sjuaero/Modeling-Gyrocopter-/docs/images/rotor_pin.png

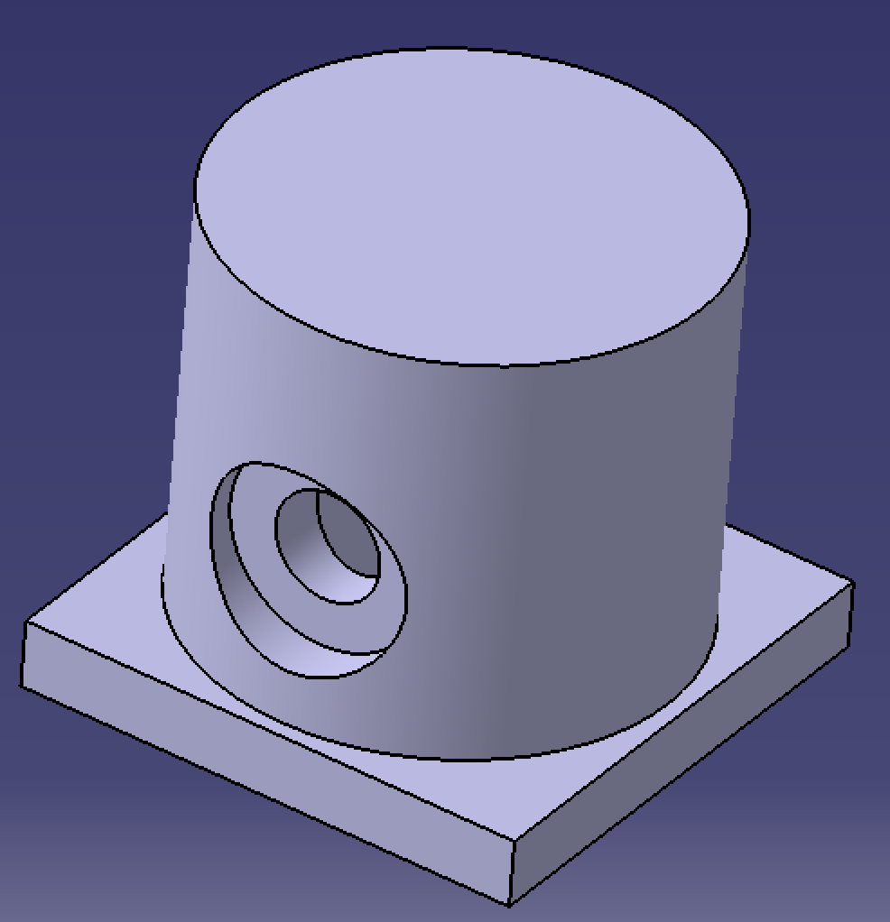
docs/images/rotor_pin.png
