sjuaero/Modeling-Gyrocopter-/docs/notes/material_selection.docx

1. 동력 프로펠러

10X7 정방향 피치

[팰콘샵] [APC] 10X7SF Slow Flyer (https://www.falconshop.co.kr/shop/goods/goods_view.php?goodsno=99995893)

->만약, 기체가 작다면 8X5

[팰콘샵] HD E-Propeller 8x5 (8050) (https://www.falconshop.co.kr/shop/goods/goods_view.php?goodsno=100003141)

2. 서보 모터

기체를 2KG 내로 선정 시,

[팰콘샵] [TOWER PRO] 타워프로 카피 SG90 9g 미니서보 / 서보혼 3가지타입 포함 (https://www.falconshop.co.kr/shop/goods/goods_view.php?goodsno=100076990&category=026005) => 최대 토크 1.8kg/cm

2kg 이상 시,

[팰콘샵] [SURPASS HOBBY] 6KG/0.16S S0600P Digital Servo (https://www.falconshop.co.kr/shop/goods/goods_view.php?goodsno=100082806)

3. 볼트 및 와셔, 너트

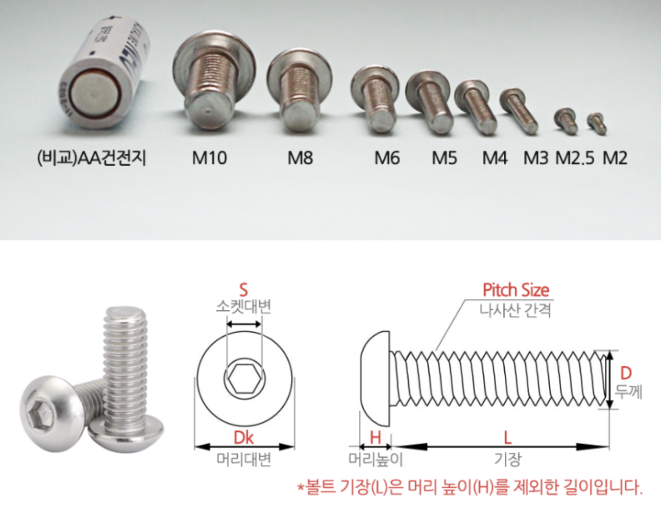
[picture p31: figure]
나사이(가) 표시된 사진 AI가 생성한 콘텐츠는 부정확할 수 있습니다.
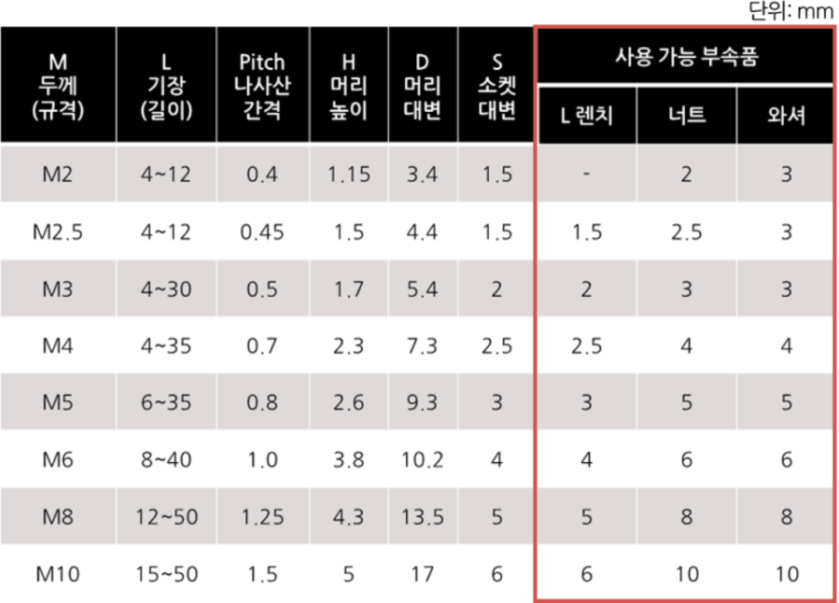
[picture p32: figure]
텍스트, 스크린샷, 번호, 폰트이(가) 표시된 사진 AI가 생성한 콘텐츠는 부정확할 수 있습니다.

필요 볼트 사이즈 : M2.5, M3 X 35, M3X 30

1. 로터 헤드

-높이 : 중앙 – 9.2cm

-높이 : 중앙 가장자리(2개) – 9.7cm

-높이 : 로터 – 로테헤드 부분(4개) – 7.64cm

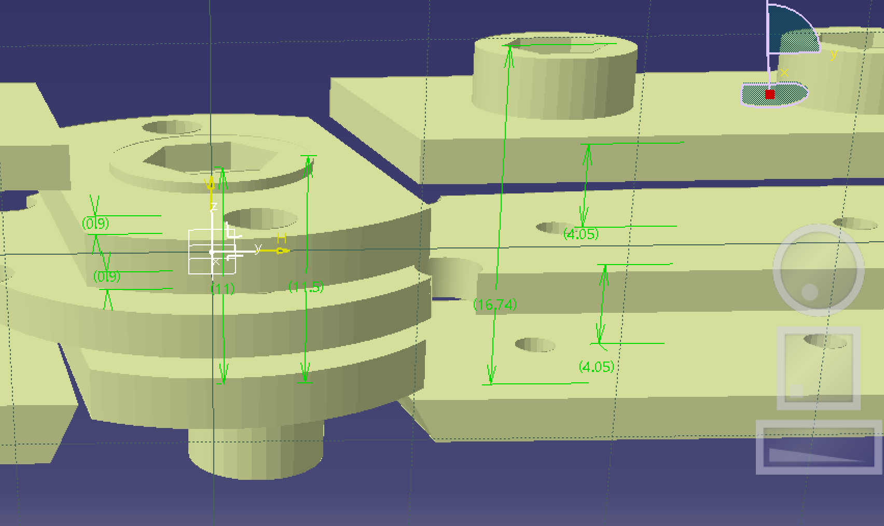
[picture p33: figure]
스크린샷, 축적 모형이(가) 표시된 사진 AI가 생성한 콘텐츠는 부정확할 수 있습니다.

-너비(로터 헤드 중앙)

소켓 대변 :

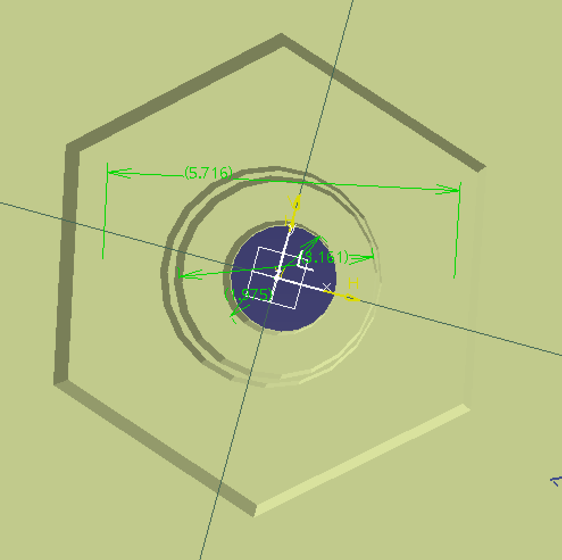
[picture p34: figure]
원, 도표, 라인, 스크린샷이(가) 표시된 사진 AI가 생성한 콘텐츠는 부정확할 수 있습니다.

- 중앙 가장자리(2개) : 파악 불가..

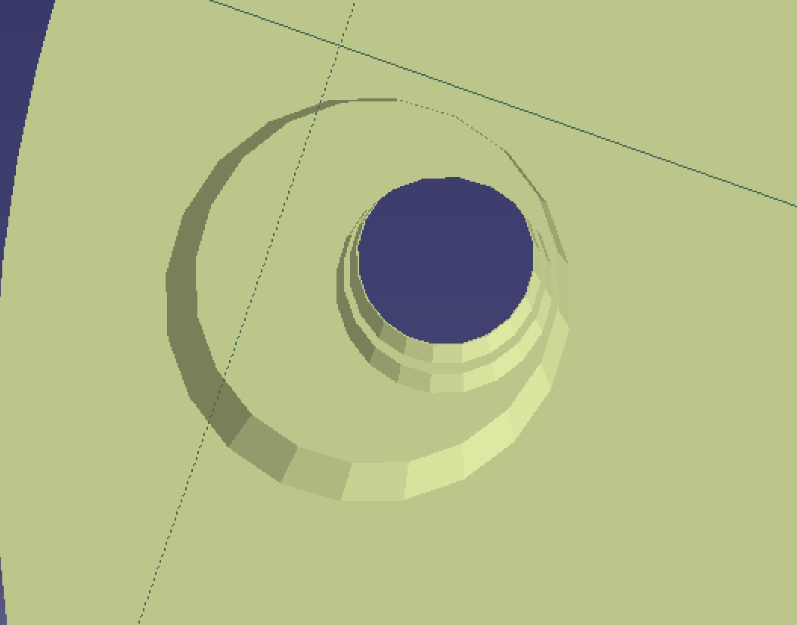
[picture p35: figure]
원, 스크린샷, 예술, 다채로움이(가) 표시된 사진 AI가 생성한 콘텐츠는 부정확할 수 있습니다.

와셔 : 불필요

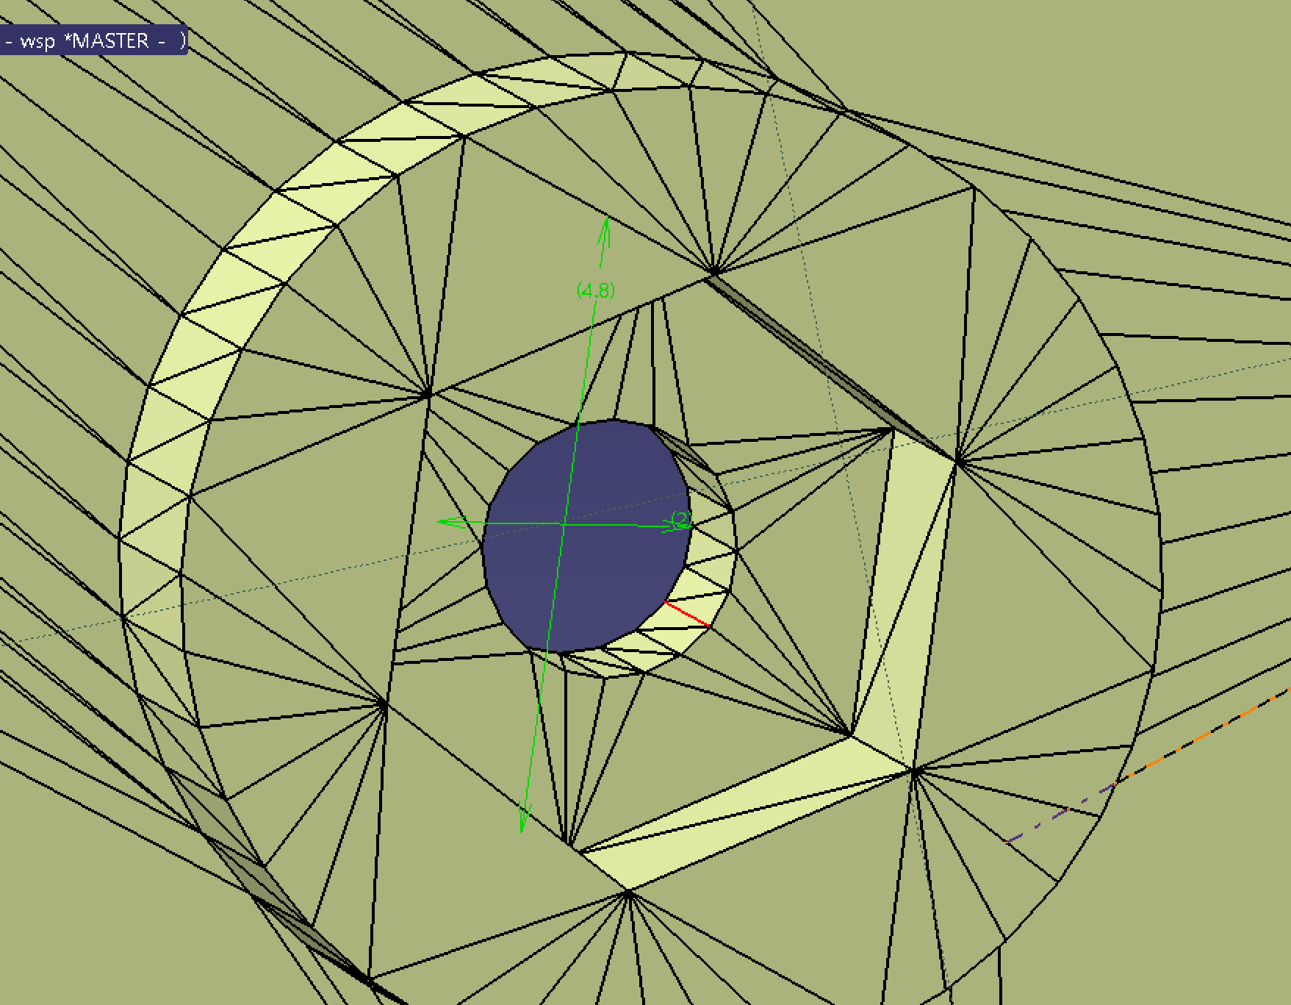
[picture p36: figure]
원, 도표, 대칭, 예술이(가) 표시된 사진 AI가 생성한 콘텐츠는 부정확할 수 있습니다.
