sjuaero/Modeling-Gyrocopter-/docs/notes/rotor_hardware_purchase_list.txt

-나사-

-로터 헤드 중앙 가운데 고정 나사 : 국산 M3x35mm 육각 나사 (열처리 완료, 8개입) 
https://www.falconshop.co.kr/shop/goods/goods_view.php?goodsno=99994021&category=033008001003

-elevator 부품 및 Hinge 연결 나사 : M3x30mm 육각 렌치 나사 (CAP SCREW) (8pcs)
https://www.falconshop.co.kr/shop/goods/goods_view.php?&goodsno=99992244

-로터 헤드 중앙 가장자리(2개 구멍) 고정 나사 : [SAB] M2.5x15mm 육각 나사 (5개입) - Goblin 500/570
https://www.falconshop.co.kr/shop/goods/goods_view.php?goodsno=99985228&category=033008001002

- 로터 elevator구동part와 동체 간 고정 나사 : 국산 M2.5x25mm 육각 볼트 (열처리 완료, 5개입)
https://www.falconshop.co.kr/shop/goods/goods_view.php?goodsno=99994018&category=033008001002

로터와 로터 헤드 간 고정 나사 : M2.5x12mm 육각 나사 (10개입)
https://www.falconshop.co.kr/shop/goods/goods_view.php?goodsno=99989512&category=033008001002

-너트-

M2.5 1.4T 인서트너트 (10개입)
https://www.falconshop.co.kr/shop/goods/goods_view.php?goodsno=100005127&category=033008002

[M25NUT] M2.5 나일론 록 너트 (10개입)
https://www.falconshop.co.kr/shop/goods/goods_view.php?goodsno=99992435&category=065003031011

M3 알루미늄 너트 (10개입, 나일론 록 타입)
https://www.falconshop.co.kr/shop/goods/goods_view.php?goodsno=100000982&category=033008002

국산 M3 너트 (스테인리스, 10개입)
https://www.falconshop.co.kr/shop/goods/goods_view.php?goodsno=99994008&category=033008002

-와셔-
elevator부분 사용 와셔 : [KYOSHO] Washer(M3x7x0.5/10pcs)
https://www.falconshop.co.kr/shop/goods/goods_view.php?goodsno=100054820&category=033008003

-기타-
Axia 엑시아 025 일반 다목적용 순간 접착제/20g
https://www.falconshop.co.kr/shop/goods/goods_view.php?goodsno=100080896&category=033005002

휠 너트 렌치 (M2 M2.5 M3 M4 나사 너트에 사용되는 렌치입니다.)
https://www.falconshop.co.kr/shop/goods/goods_view.php?goodsno=100086690&category=065003055005

-링키지 : 2mm 푸시로드 (링키지용 강선 철사) 길이 1000mm
https://www.falconshop.co.kr/shop/goods/goods_view.php?goodsno=16701127&category=011004004001

-볼링크 : 2mm x L18 볼 조인트 with 볼트 흑색 5pcs
https://www.falconshop.co.kr/shop/goods/goods_view.php?goodsno=100000573&category=011004004006

-볼베어링
3x8x4mm 베어링 (MR693ZZ)
https://www.falconshop.co.kr/shop/goods/goods_view.php?goodsno=99989734&category=033006001

(바로 아래 주소는 구매x)
https://www.navimro.com/g/3175927/?utm_source <-현재 부품에 딱 맞는 사이즈이지만, 출고 한달 예정.. 그래서 구매하긴 어려울 예정
