sjuaero/Modeling-Gyrocopter-/cad/exports/assembly_2_twin_boom.stp

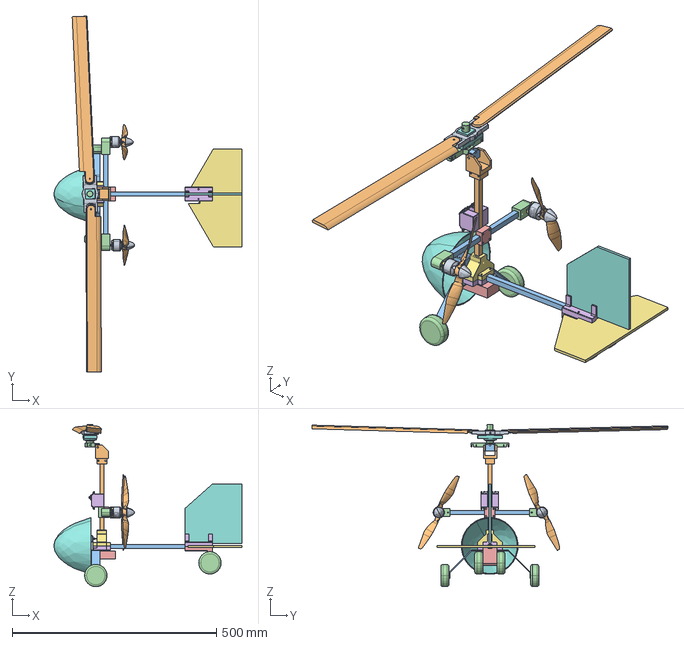
[picture p37: CAD file, 2026-09-29]
cad/exports/assembly_2_twin_boom.stp
460.3 x 871.0 x 397.6 mm
