sjuaero/Modeling-Gyrocopter-/print/rotor_v2/rotor_hub_3.stl

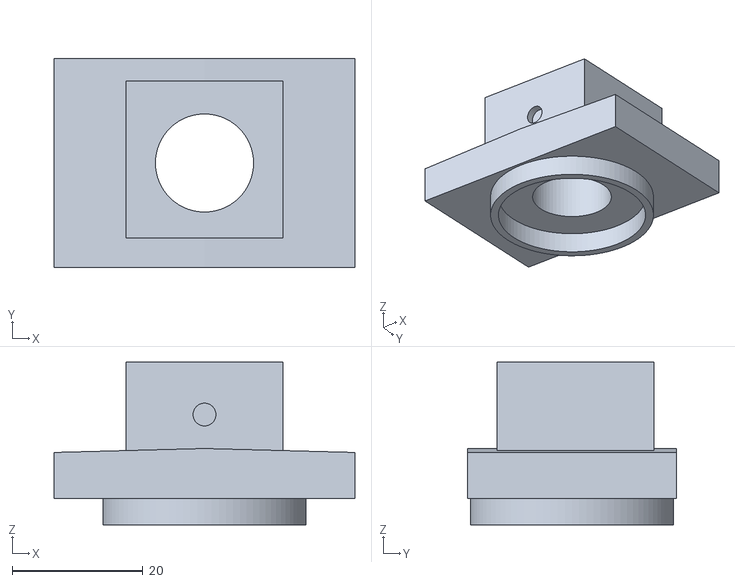
[picture p38: CAD file, 2026-09-29]
print/rotor_v2/rotor_hub_3.stl
46.0 x 32.0 x 24.8
