sjuaero/Modeling-Gyrocopter-/print/rotor_v2/real_rotorhead_0822.stl

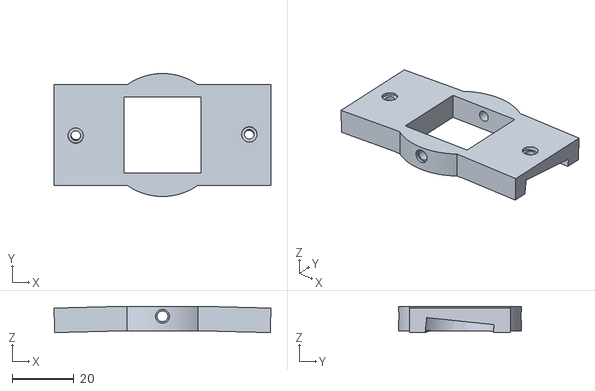
[picture p39: CAD file, 2026-09-29]
print/rotor_v2/real_rotorhead_0822.stl
70.6 x 40.0 x 8.54
