sjuaero/Modeling-Gyrocopter-/print/rotor_v2/shaft.stl

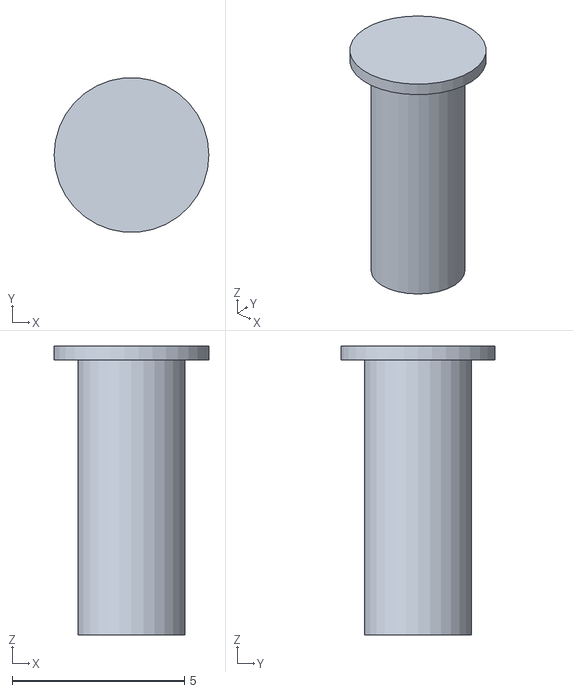
[picture p40: CAD file, 2026-09-29]
print/rotor_v2/shaft.stl
4.50 x 4.48 x 8.40
