sjuaero/Modeling-Gyrocopter-/print/rotor_v2/stopper.stl

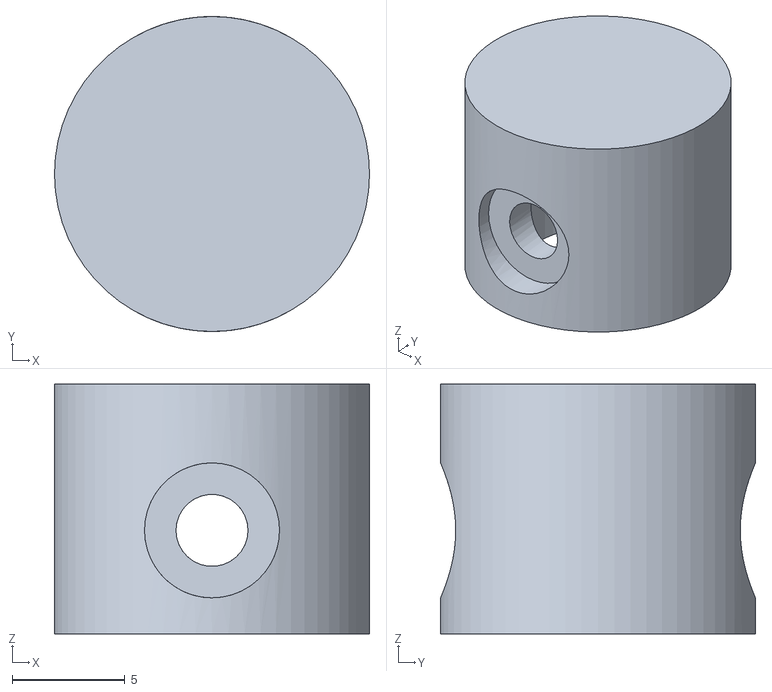
[picture p41: CAD file, 2026-09-29]
print/rotor_v2/stopper.stl
14.0 x 14.0 x 11.1
