sjuaero/Modeling-Gyrocopter-/print/rotor_v2/last_rotor_base_3.stl

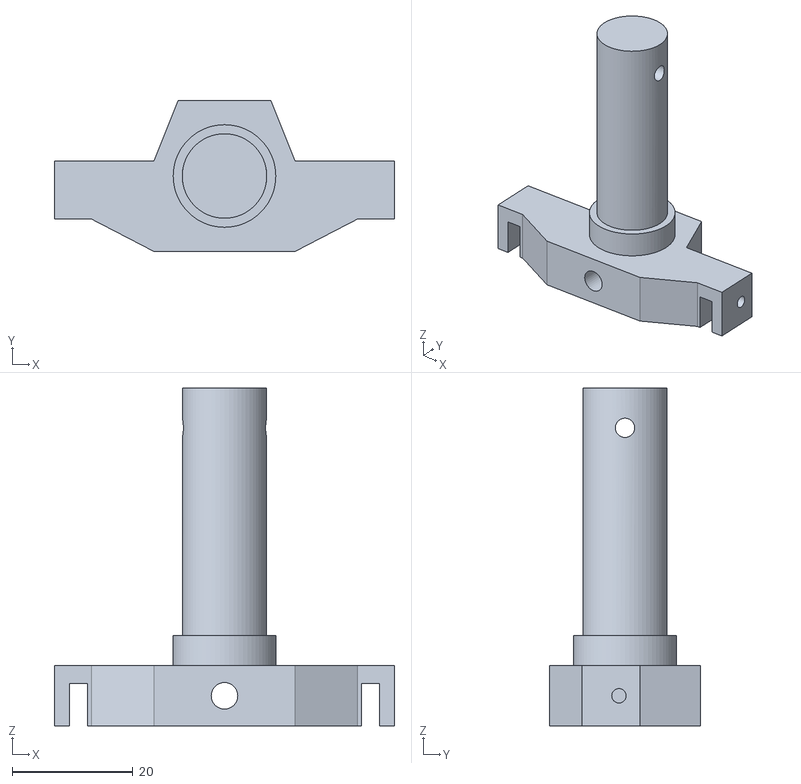
[picture p42: CAD file, 2026-09-29]
print/rotor_v2/last_rotor_base_3.stl
56.3 x 25.0 x 56.0
