sjuaero/Modeling-Gyrocopter-/print/rotor_v1/last_rotor_base.stl

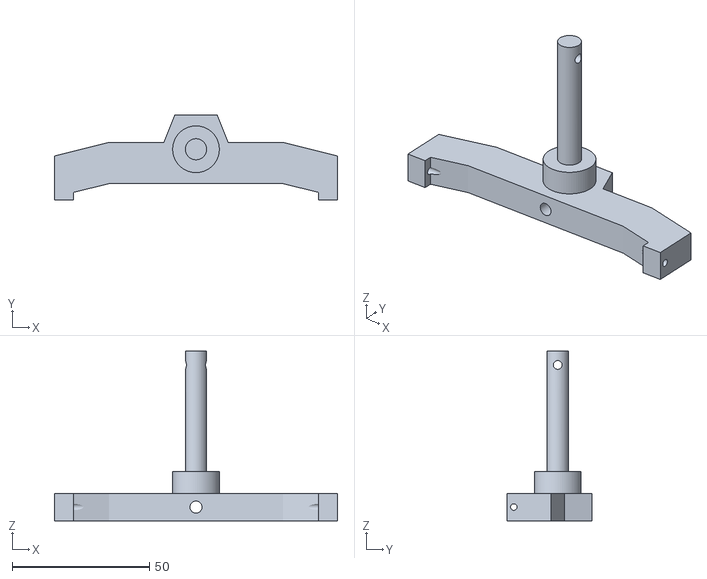
[picture p43: CAD file, 2026-09-29, an earlier design]
print/rotor_v1/last_rotor_base.stl
103.0 x 31.0 x 61.7
