sjuaero/Modeling-Gyrocopter-/print/rotor_v1/rotor_hub.stl

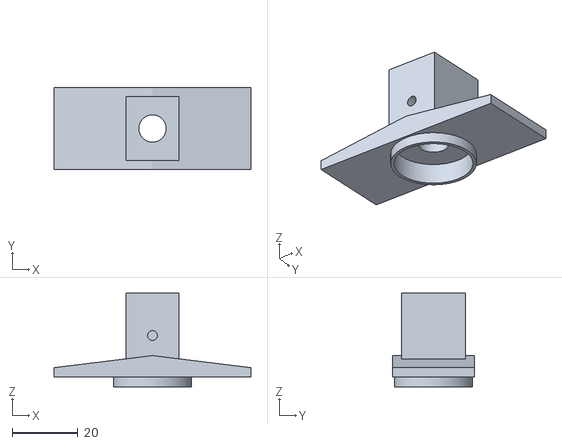
[picture p44: CAD file, 2026-09-29, an earlier design]
print/rotor_v1/rotor_hub.stl
60.0 x 25.0 x 28.5
