sjuaero/Modeling-Gyrocopter-/print/rotor_v1/elevator_parts2.stl

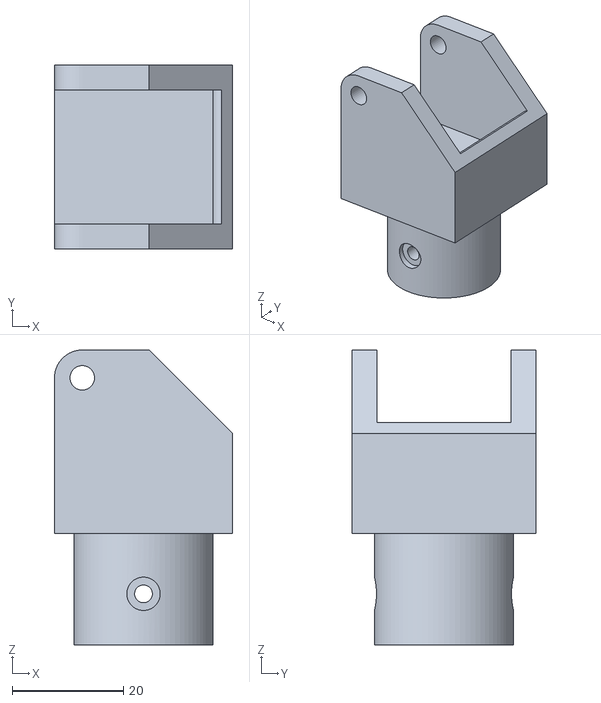
[picture p45: CAD file, 2026-09-29, an earlier design]
print/rotor_v1/elevator_parts2.stl
32.0 x 33.0 x 53.0
