sjuaero/Modeling-Gyrocopter-/print/rotor_v1/shaft.stl

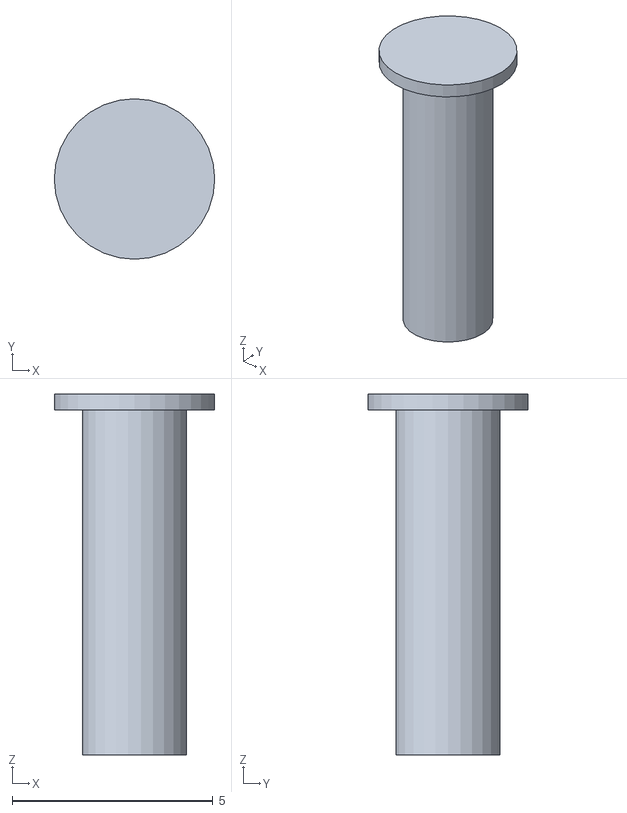
[picture p46: CAD file, 2026-09-29, an earlier design]
print/rotor_v1/shaft.stl
4.00 x 4.00 x 9.00
