sjuaero/Modeling-Gyrocopter-/(list of files, cad)

Other CAD files:
print/rotor_v2/rotor_set.gcode.3mf
cad/aircraft_v1_rotor_development/608 ZZ Bearing.CATPart
cad/aircraft_v1_rotor_development/608 ZZ Bearing.CATProduct
cad/aircraft_v1_rotor_development/7.21_part_frame.CATProduct
cad/aircraft_v1_rotor_development/Cage.CATPart
cad/aircraft_v1_rotor_development/ES3352.CATPart.catpart
cad/aircraft_v1_rotor_development/ESC.CATPart.catpart
cad/aircraft_v1_rotor_development/FC.CATPart.catpart
cad/aircraft_v1_rotor_development/Inner.CATPart
cad/aircraft_v1_rotor_development/Outer.CATPart
cad/aircraft_v1_rotor_development/PM02/PM02.CATPart
cad/aircraft_v1_rotor_development/Part4.CATPart
cad/aircraft_v1_rotor_development/Product2.CATProduct.catproduct
cad/aircraft_v1_rotor_development/SKFRO A.CATPart.catpart
cad/aircraft_v1_rotor_development/Symmetry of Part21.CATPart
cad/aircraft_v1_rotor_development/assemble/7.21_part_frame.CATProduct
cad/aircraft_v1_rotor_development/assemble/banpozyro_.CATProduct
cad/aircraft_v1_rotor_development/assemble/last_assembly_rotor.CATProduct
cad/aircraft_v1_rotor_development/assembly_final.CATPart
cad/aircraft_v1_rotor_development/assembly_final_real.CATPart
cad/aircraft_v1_rotor_development/banpozyro2.CATPart
cad/aircraft_v1_rotor_development/banpozyro_.CATProduct
cad/aircraft_v1_rotor_development/carbon_body.CATPart.catpart
cad/aircraft_v1_rotor_development/carbon_pipe_M2.CATPart
cad/aircraft_v1_rotor_development/carbon_roter.CATPart.catpart
cad/aircraft_v1_rotor_development/clevis/clevis.CATPart
cad/aircraft_v1_rotor_development/elevator_parts2.CATPart
cad/aircraft_v1_rotor_development/frame+carbon parts.CATPart
cad/aircraft_v1_rotor_development/frame2.CATPart.catpart
cad/aircraft_v1_rotor_development/frame2_plus_mount.CATPart.catpart
cad/aircraft_v1_rotor_development/frame_assemble.CATPart.catpart
cad/aircraft_v1_rotor_development/frame_carbon_rotor.CATProduct
cad/aircraft_v1_rotor_development/frame_carbon_rotor_7.12.CATProduct
cad/aircraft_v1_rotor_development/horn A.CATPart.catpart
cad/aircraft_v1_rotor_development/landinggear.CATPart.catpart
cad/aircraft_v1_rotor_development/last_rotor_assembly.CATProduct
cad/aircraft_v1_rotor_development/last_rotor_base.CATPart
cad/aircraft_v1_rotor_development/last_rotor_base_2.CATPart
cad/aircraft_v1_rotor_development/linkage_stopper/linkage_stopper.CATPart
cad/aircraft_v1_rotor_development/moter mount.CATPart.catpart
cad/aircraft_v1_rotor_development/moter.CATPart.catpart
cad/aircraft_v1_rotor_development/motor_pin.CATPart
cad/aircraft_v1_rotor_development/new_rotor_assembly_twin_boom_transition/9.5.CATPart
cad/aircraft_v1_rotor_development/new_rotor_assembly_twin_boom_transition/9.8.CATPart
cad/aircraft_v1_rotor_development/new_rotor_assembly_twin_boom_transition/frame_up.CATPart.catpart
cad/aircraft_v1_rotor_development/new_rotor_assembly_twin_boom_transition/hurry_new_rotor_head_wedge4.CATPart
cad/aircraft_v1_rotor_development/new_rotor_assembly_twin_boom_transition/hurry_new_rotor_head_wedge6.CATPart
cad/aircraft_v1_rotor_development/new_rotor_assembly_twin_boom_transition/motor_cross.CATPart
cad/aircraft_v1_rotor_development/new_rotor_assembly_twin_boom_transition/new_elevator_parts.CATPart
cad/aircraft_v1_rotor_development/new_rotor_assembly_twin_boom_transition/new_motoraxis_mount_down.CATPart
cad/aircraft_v1_rotor_development/new_rotor_assembly_twin_boom_transition/new_motoraxis_mount_up.CATPart
cad/aircraft_v1_rotor_development/new_rotor_assembly_twin_boom_transition/new_rotor_assembly_7.22.CATProduct
cad/aircraft_v1_rotor_development/new_rotor_assembly_twin_boom_transition/new_rotor_wedge4_assembly.CATProduct
cad/aircraft_v1_rotor_development/new_rotor_assembly_twin_boom_transition/rotor_head_base_real_new.CATPart
cad/aircraft_v1_rotor_development/new_rotor_assembly_twin_boom_transition/rotor_head_base_real_new_wedge3.CATPart
cad/aircraft_v1_rotor_development/new_rotor_assembly_twin_boom_transition/stopper_emergency.CATPart
cad/aircraft_v1_rotor_development/new_rotor_assembly_twin_boom_transition/twin_boom_assembly_test.CATProduct
cad/aircraft_v1_rotor_development/new_rotor_assembly_twin_boom_transition/twin_boom_mount.CATPart
cad/aircraft_v1_rotor_development/new_rotor_assembly_twin_boom_transition/twin_boom_mount_2_down.CATPart
cad/aircraft_v1_rotor_development/new_rotor_assembly_twin_boom_transition/twin_boom_mount_2_up.CATPart
cad/aircraft_v1_rotor_development/new_rotor_assembly_twin_boom_transition/twin_motor_base.CATPart
cad/aircraft_v1_rotor_development/nono.CATPart
cad/aircraft_v1_rotor_development/nosecone23deg.CATPart.catpart
cad/aircraft_v1_rotor_development/pixhawk_6c_mini/PIXHAWK 6C MINI Assembly.CATProduct
cad/aircraft_v1_rotor_development/pixhawk_6c_mini/PIXHAWK 6C MINI Assembly_part.CATPart
cad/aircraft_v1_rotor_development/pixhawk_6c_mini/PIXHAWK 6C MINI.CATPart
cad/aircraft_v1_rotor_development/pixhawk_6c_mini/Pin.CATPart
cad/aircraft_v1_rotor_development/pixhawk_6c_mini/SM04B-GHS-TB.CATPart
cad/aircraft_v1_rotor_development/pixhawk_6c_mini/SM05B-GHS-TB.CATPart
cad/aircraft_v1_rotor_development/pixhawk_6c_mini/SM06B-GHS-TB.CATPart
cad/aircraft_v1_rotor_development/pixhawk_6c_mini/SM06B-SRSS-TB.CATPart
cad/aircraft_v1_rotor_development/pixhawk_6c_mini/SM10B-GHS-TB.CATPart
cad/aircraft_v1_rotor_development/pixhawk_6c_mini/USB_type_C_smd_12ps.CATPart
cad/aircraft_v1_rotor_development/pixhawk_6c_mini/jst-1.5mm-3P.CATPart
cad/aircraft_v1_rotor_development/propeller/APC 8x8E.CATPart
cad/aircraft_v1_rotor_development/propeller/propeller.CATProduct
cad/aircraft_v1_rotor_development/push_rod.CATPart
cad/aircraft_v1_rotor_development/radio_receiver/Antena, R9DS RadioLink Receiver.CATPart
cad/aircraft_v1_rotor_development/radio_receiver/Base, 2.54 mm Male Header Dupont Pins, Configurable_1X3.CATPart
cad/aircraft_v1_rotor_development/radio_receiver/Base, 2.54 mm Male Header Dupont Pins, Configurable_1X4.CATPart
cad/aircraft_v1_rotor_development/radio_receiver/Base, 2.54 mm Male Header Dupont Pins, Configurable_3X8.CATPart
cad/aircraft_v1_rotor_development/radio_receiver/Body, R9DS RadioLink Receiver.CATPart
cad/aircraft_v1_rotor_development/radio_receiver/Pin, 2.54 mm Male Header Dupont Pins, Configurable^2.54 mm Male Header Dupont Pins, Configurable, 1X3.CATPart
cad/aircraft_v1_rotor_development/radio_receiver/Pin, 2.54 mm Male Header Dupont Pins, Configurable^2.54 mm Male Header Dupont Pins, Configurable, 1X4.CATPart
cad/aircraft_v1_rotor_development/radio_receiver/Pin, 2.54 mm Male Header Dupont Pins, Configurable^2.54 mm Male Header Dupont Pins, Configurable, 3X8.CATPart
cad/aircraft_v1_rotor_development/radio_receiver/R9DS RadioLink Receiver Assy.CATProduct
cad/aircraft_v1_rotor_development/radio_receiver/radio_receiver.CATProduct
cad/aircraft_v1_rotor_development/rotor_assembly2.CATPart
cad/aircraft_v1_rotor_development/rotor_assembly3.CATPart
cad/aircraft_v1_rotor_development/rotor_head_base_real.CATPart
cad/aircraft_v1_rotor_development/rotor_head_base_real_2.CATPart
cad/aircraft_v1_rotor_development/rotor_head_base_real_2_upp.CATPart
cad/aircraft_v1_rotor_development/rotor_head_base_real_up.CATPart
cad/aircraft_v1_rotor_development/rotor_hub.CATPart
cad/aircraft_v1_rotor_development/rotorblade_example.CATPart
cad/aircraft_v1_rotor_development/rotro_assembly.CATPart
cad/aircraft_v1_rotor_development/servo/servo__motor.CATPart
cad/aircraft_v1_rotor_development/servo/servo_arm.CATPart
cad/aircraft_v1_rotor_development/servo__motor.CATPart
cad/aircraft_v1_rotor_development/servo_arm_tail.CATPart
cad/aircraft_v1_rotor_development/skywalker_esc/skywalker_esc_part.CATPart
cad/aircraft_v1_rotor_development/spahqla A.CATPart.catpart
cad/aircraft_v1_rotor_development/spin_axis.CATPart
cad/aircraft_v1_rotor_development/tail f.CATPart.catpart
cad/aircraft_v1_rotor_development/tail_assembly/SKFRO A.CATPart.catpart
cad/aircraft_v1_rotor_development/tail_assembly/horn A.CATPart.catpart
cad/aircraft_v1_rotor_development/tail_assembly/spahqla A.CATPart.catpart
cad/aircraft_v1_rotor_development/tail_assembly/tail go.CATPart
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
