sjuaero/Modeling-Gyrocopter-/docs/images/rotor_assembly.png

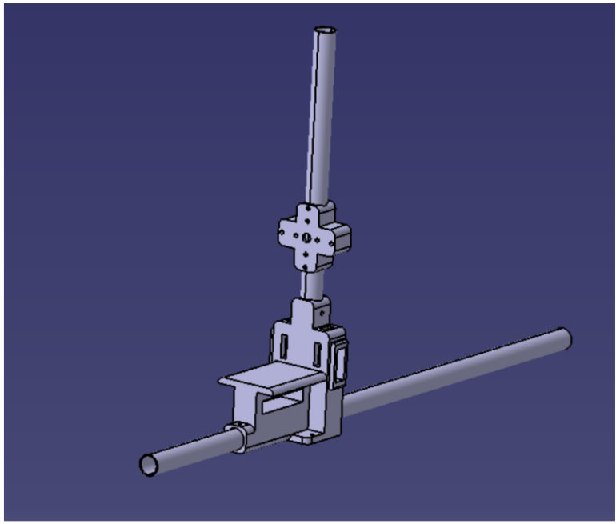
docs/images/rotor_assembly.png
